jonjenkins31/Gradschool-Tactile-Sensor/DESIGN/66838005697__0D160AFB-0B24-4D78-8E8D-9A56586D88BA.jpeg

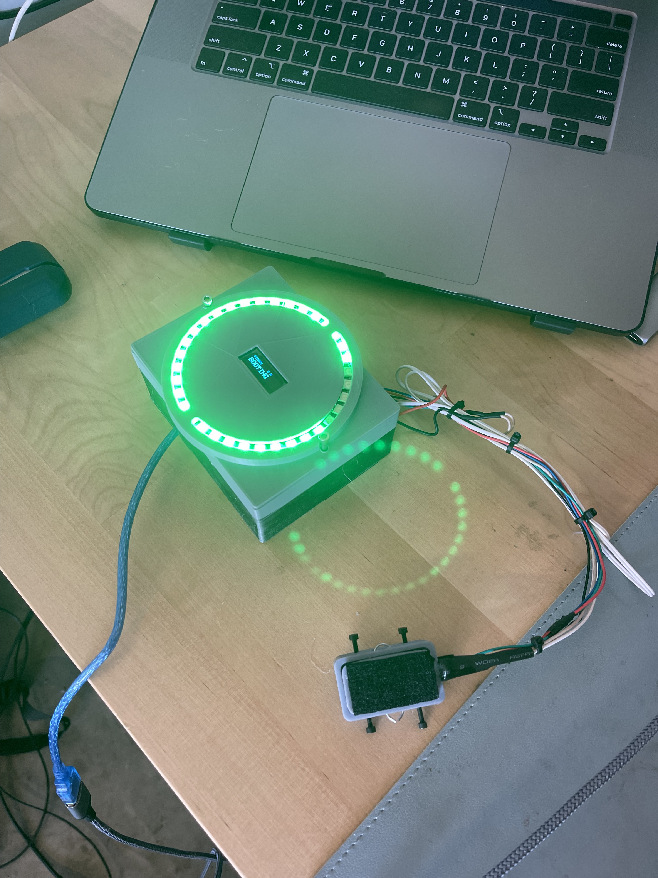
DESIGN/66838005697__0D160AFB-0B24-4D78-8E8D-9A56586D88BA.jpeg
