jonjenkins31/Gradschool-Tactile-Sensor/DIAGRAMS/SmartLedT4V5TeensyPinout.png

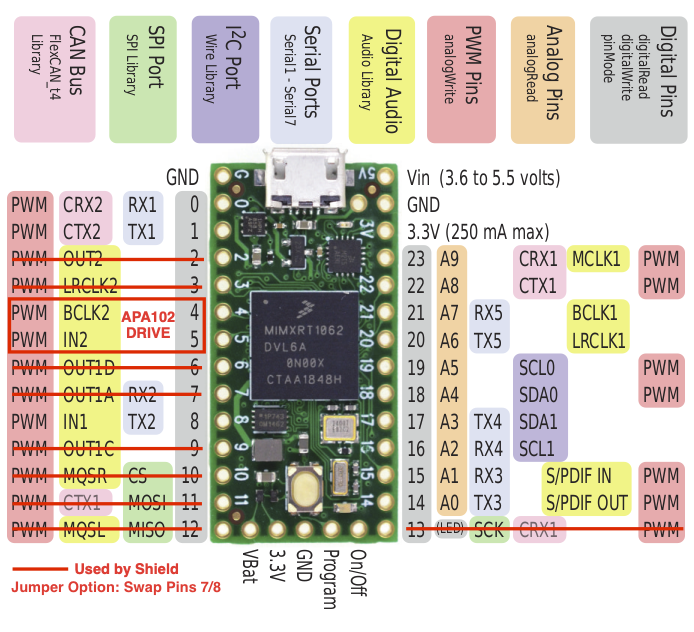
DIAGRAMS/SmartLedT4V5TeensyPinout.png
