jonjenkins31/Gradschool-Tactile-Sensor/README.md

## Grad School
# Grad School Tactile Sensor  

<!-- This is commented out.

 -->

## Project Information

Project Status : <mark style="background-color: green"> &nbsp; COMPLETED &nbsp;</mark>  
Code Status : <mark style="background-color: green"> &nbsp; GOOD &nbsp;</mark>  
Development Status : <mark style="background-color: red"> &nbsp; NOT ACTIVE &nbsp;</mark>  

&nbsp;
## General Information

 This is the project files for a biorobotic Tactile sensor. This is the first project for my biorobotics class. The goal of this project was to develope a robotic sensor capable of 3 types of sensor feedback. The project had the following key features: 
- [x] FDR sensor
- [x] Temperatre Sensor
- [x] Hall Effect sensor
- [x] LCD for text information and mode selection

&nbsp;
## WATCH NOW ON YOUTUBE

 Watch the project playlist on youtube. 

 &nbsp;

image alt text (https://www.youtube.com/watch?v=HfbRuyMDvio "YouTube")

-->

&nbsp;
## Support

Did this project help you? Consider supporting! 

Consider Subscribing: https://bit.ly/2DgZyuq <br>
Patreon ➔ https://www.patreon.com/JenkinsRobotics <br>
Venmo ➔ https://venmo.com/u/JenkinsRobotics <br>

&nbsp;
## Table of Contents

**[Project File Structure](#project-file-structure)**<br>
**[Installation Instructions](#installation-instructions)**<br>
**[Next Steps](#next-steps)**<br>
**[Components](#components)**<br>
**[Notes and Miscellaneous](#notes-and-miscellaneous)**<br>
**[Links](#links)**<br>

&nbsp;
## Project File Structure

The following is a breakdown of the different folders and the files contained in them:

1. **CAD**
    - A copy of my CAD assembly for this project in different formats.
    **Directions:**
      - Upload to your CAD file of chose to view files.

    &nbsp;
2. **CODE**  
   - This folder contains a copy all the arduino code I wrote for this project. Each file handels a specific task  and is called upon when needed. Documentation of the code is minimal. 

    &nbsp;
3. **DESIGN**
    - Contains copy of images of machine. 

    &nbsp;
4. **DIAGRAMS**
    - Contains copy of wire diagrams and any other prints.
   
    &nbsp;
5. **GH PAGES**
    - Files used for Github Pages and readme text file. 

    &nbsp;
6. **DOCUMENTS**
   - Contains user manuals for certain items  and submited documentation related for the project. 
    
      &nbsp;
7. **REFERENCES**
   - Contain random additional information used for the project. Including notes, images, reference code, etc. 

> Note: Files are not optimized and could contain unused code, references, documents. 

<!-- This is commented out.  

&nbsp;
## Installation Instructions

Installation instructions can be found in the youtube video linked below 
 
 ### Video link  be updated soon

[![image alt text](http://img.youtube.com/vi/w-qWbZ5-IQw/0.jpg)](https://youtube.com/playlist?list=PLNTKXZ4hgP_jekZOWw05JcJtyseCdSsIV "YouTube")

 -->

&nbsp;
## Next Steps

This project is now completed. No next steps are planned. We can release bug fixes if found. 

If you require assistant join our discord channel linked down below.

&nbsp;
## Components 

The following is a breakdown of key components for this project:
&nbsp;
| Item | Function | Cost  |
| --- |:---:| -----:|
| Fusion 360 | CAD | Free |
| arduio ide | Text Editor | Free |

&nbsp;
## Notes and Miscellaneous

Disclaimer :
Modify and use at your own risk. Code/project was not developed for mass production/use

**ENJOY!!**

That’s  all Folks. Hope this can help you in some way.
... Consider Supporting Us Down Below. 

&nbsp;
## Links

SUPPORT US ► 

Consider Subscribing: https://bit.ly/2DgZyuq <br>
Patreon ➔ https://www.patreon.com/JenkinsRobotics  <br>
Venmo ➔ https://venmo.com/u/JenkinsRobotics <br>

FOLLOW US ►

Discord ➔ https://discord.gg/sAnE5pRVyT <br>
Patreon ➔ https://www.patreon.com/JenkinsRobotics <br>
Twitter ➔ https://twitter.com/j <br>
Instagram  ➔ https://www.instagram.com/jenkinsrobotics/ <br>
Facebook ➔ https://www.facebook.com/jenkinsrobotics/  <br>
GitHub  ➔ https://jenkinsrobotics.github.io <br>
