jonjenkins31/Gradschool-Tactile-Sensor/DIAGRAMS/Screen Shot 2022-03-02 at 5.42.21 PM.png

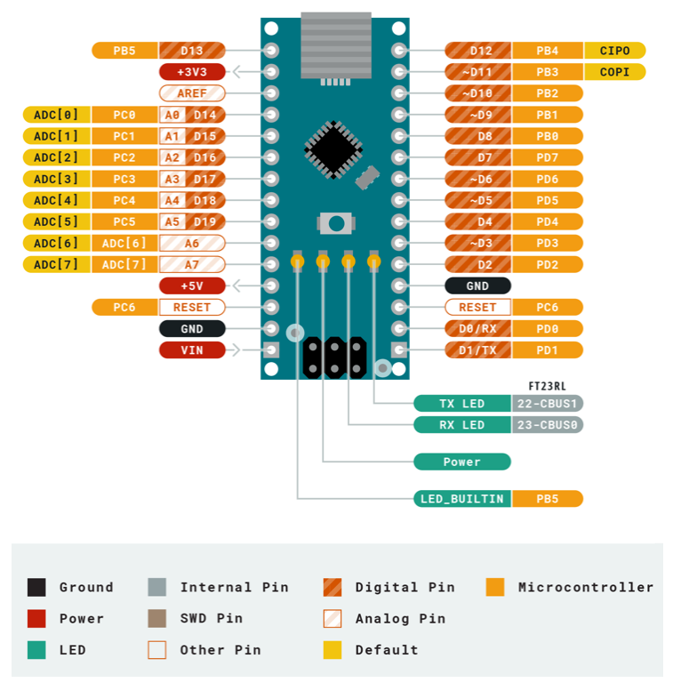
DIAGRAMS/Screen Shot 2022-03-02 at 5.42.21 PM.png
