jonjenkins31/Gradschool-Tactile-Sensor/DIAGRAMS/Screen Shot 2022-03-02 at 5.44.11 PM.png

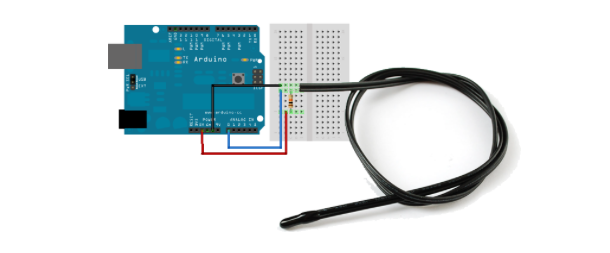
DIAGRAMS/Screen Shot 2022-03-02 at 5.44.11 PM.png
