jonjenkins31/Gradschool-Tactile-Sensor/DIAGRAMS/Screen Shot 2022-03-02 at 9.01.36 AM.png

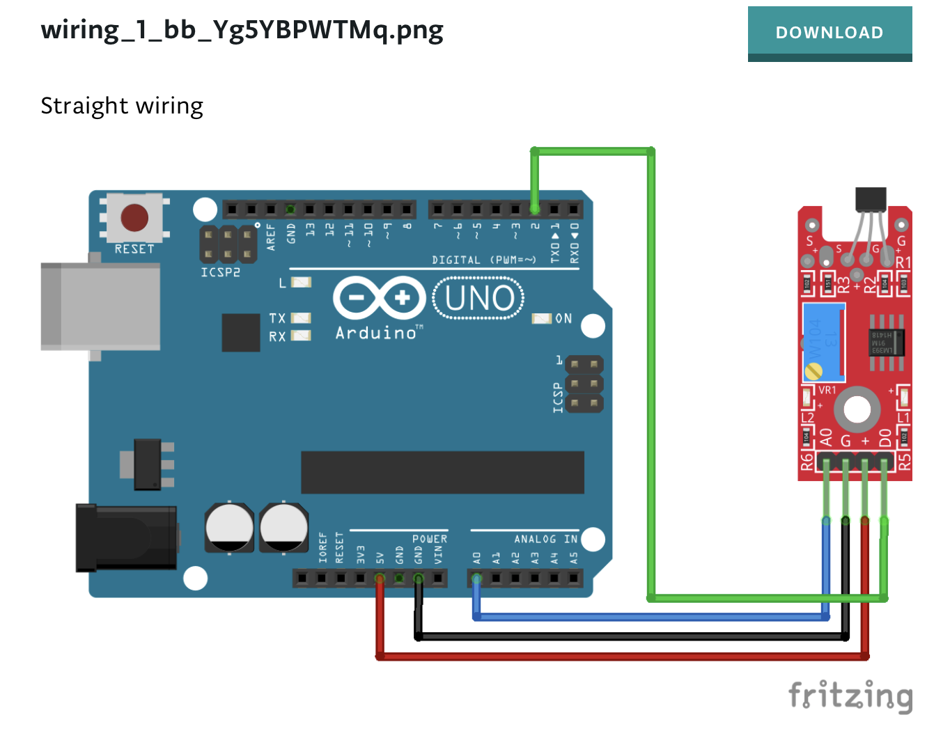
DIAGRAMS/Screen Shot 2022-03-02 at 9.01.36 AM.png
