jonjenkins31/Gradschool-Tactile-Sensor/DIAGRAMS/Screen Shot 2022-03-02 at 12.11.30 PM.png

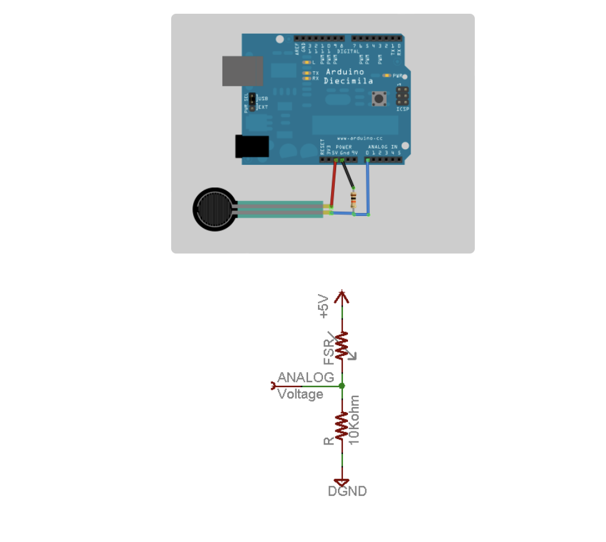
DIAGRAMS/Screen Shot 2022-03-02 at 12.11.30 PM.png
