jonjenkins31/Gradschool-Tactile-Sensor/DIAGRAMS/Screen Shot 2022-03-02 at 12.12.20 PM.png

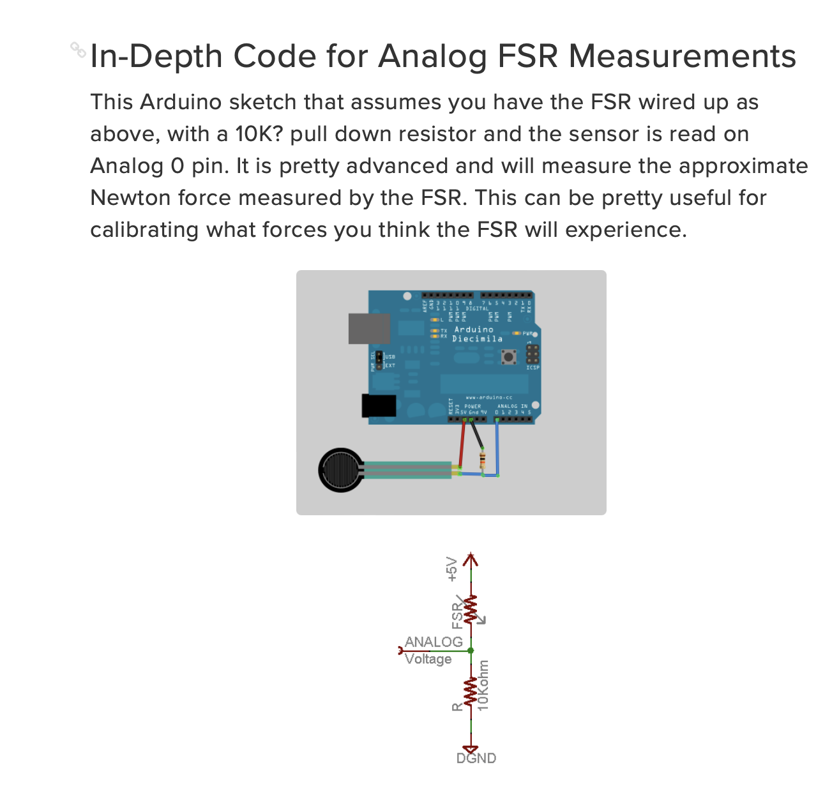
DIAGRAMS/Screen Shot 2022-03-02 at 12.12.20 PM.png
