jonjenkins31/Gradschool-Tactile-Sensor/DIAGRAMS/sensors_LIS3DH_sch.png

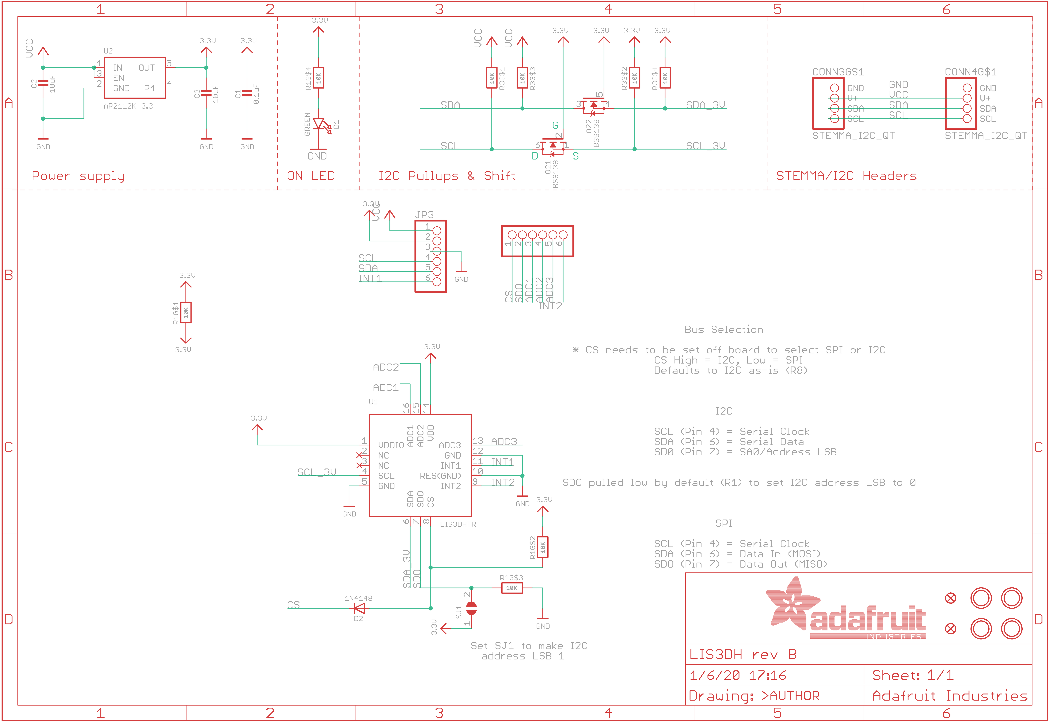
DIAGRAMS/sensors_LIS3DH_sch.png
