jonjenkins31/Gradschool-Tactile-Sensor/REFERENCES/CODE-master/PROJECT CODE/Gloves/MiMu xOSC Gloves/OSC-illoscope-master/OSC-illoscope With Triple-Axis Accelerometer.png

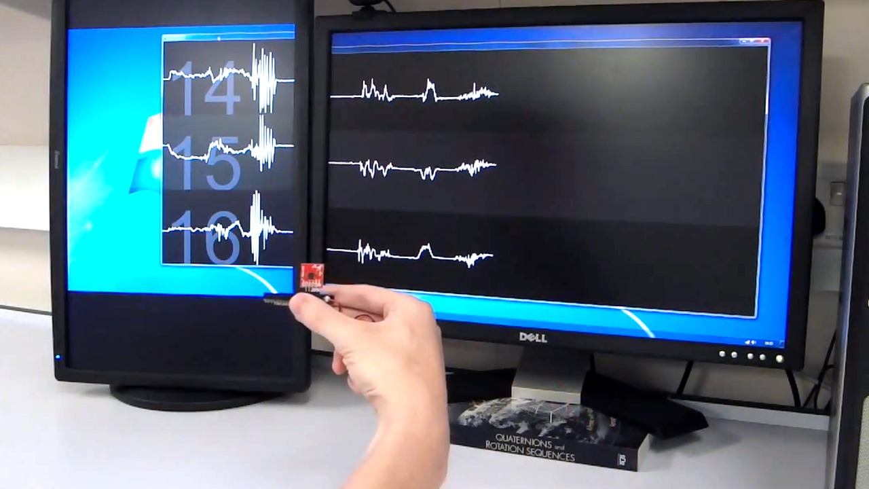
REFERENCES/CODE-master/PROJECT CODE/Gloves/MiMu xOSC Gloves/OSC-illoscope-master/OSC-illoscope With Triple-Axis Accelerometer.png
