jonjenkins31/Gradschool-Tactile-Sensor/REFERENCES/CODE-master/PROJECT CODE/rSkin/Processing/robot_skin_8chan_graph/screen-1137.tif

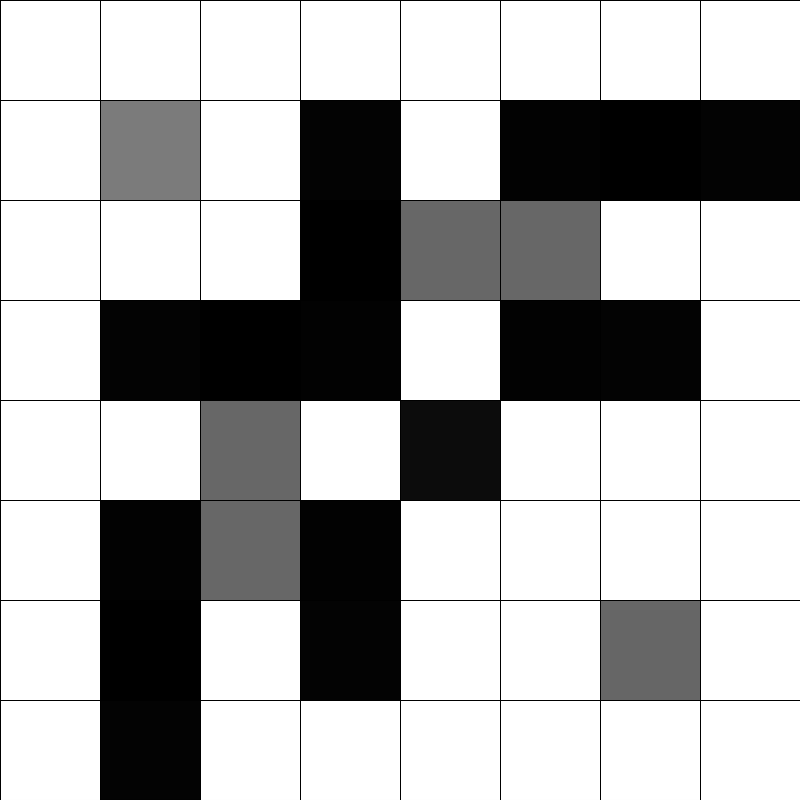
REFERENCES/CODE-master/PROJECT CODE/rSkin/Processing/robot_skin_8chan_graph/screen-1137.tif
