jonjenkins31/Gradschool-Tactile-Sensor/REFERENCES/CODE-master/PROJECT CODE/rSkin/Processing/robot_skin_square4/screen-6268.tif

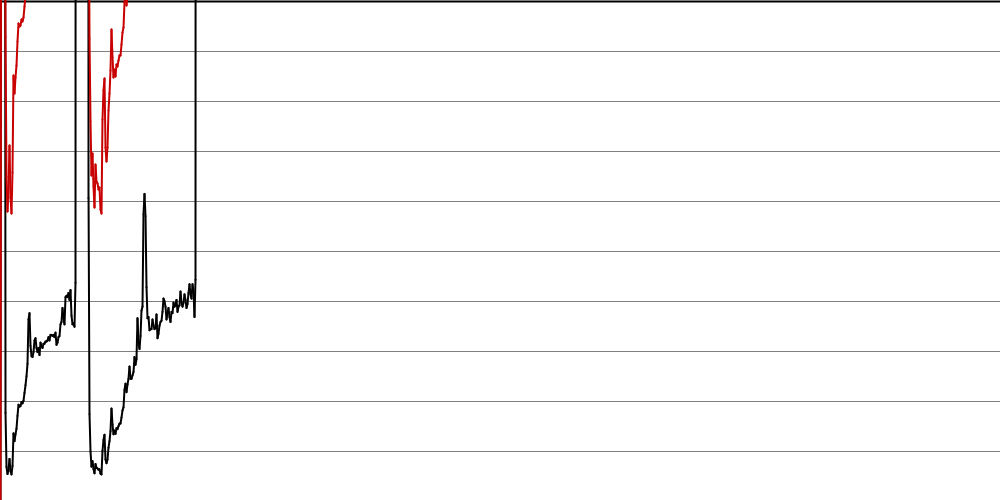
REFERENCES/CODE-master/PROJECT CODE/rSkin/Processing/robot_skin_square4/screen-6268.tif
