jonjenkins31/Gradschool-Tactile-Sensor/REFERENCES/CODE-master/PROJECT CODE/rSkin/Processing/robot_skin_square4/screen-7118.tif

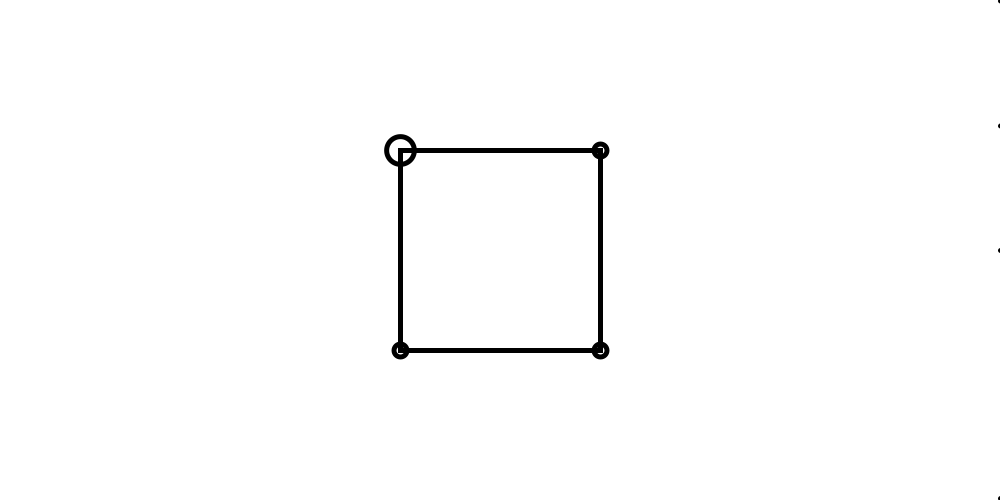
REFERENCES/CODE-master/PROJECT CODE/rSkin/Processing/robot_skin_square4/screen-7118.tif
