jonjenkins31/Gradschool-Tactile-Sensor/REFERENCES/CODE-master/WORKSHOP CODE/OTS-LilyPadArduino/sketches/01 Hello World/blink.jpg

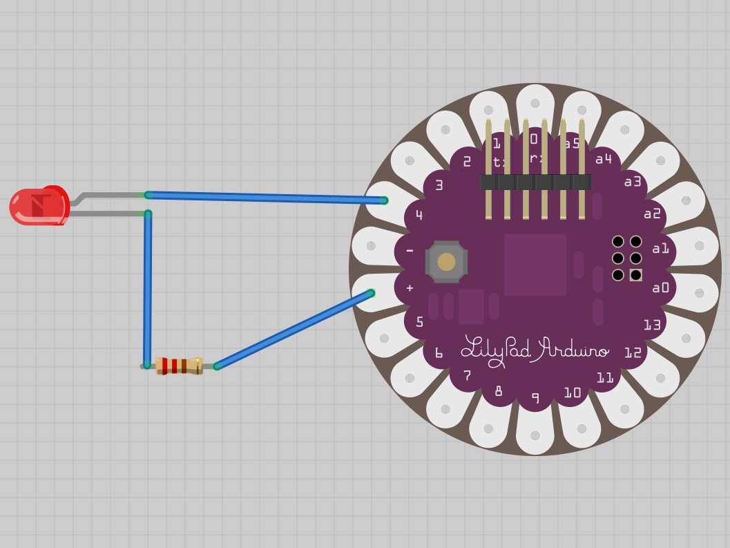
REFERENCES/CODE-master/WORKSHOP CODE/OTS-LilyPadArduino/sketches/01 Hello World/blink.jpg
