jonjenkins31/Gradschool-Tactile-Sensor/REFERENCES/CODE-master/WORKSHOP CODE/OTS-LilyPadArduino/sketches/02 Brightness/fade.jpg

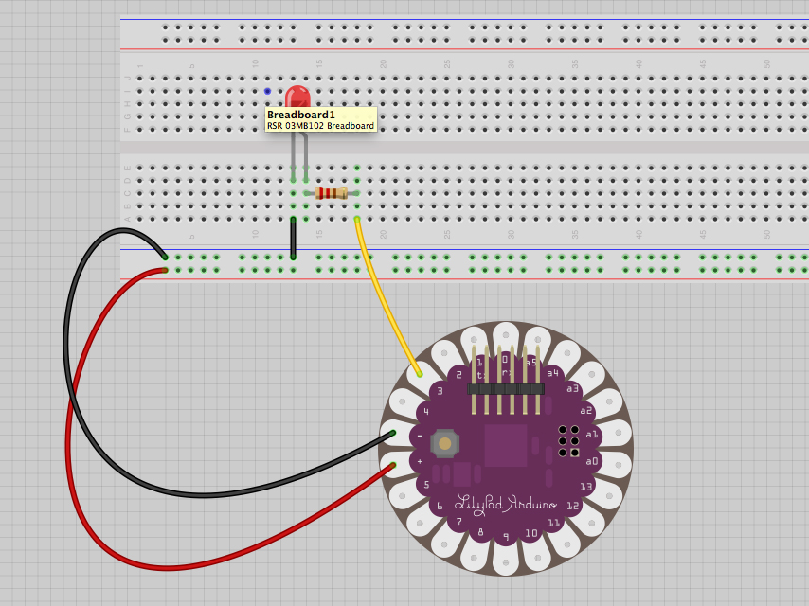
REFERENCES/CODE-master/WORKSHOP CODE/OTS-LilyPadArduino/sketches/02 Brightness/fade.jpg
