jonjenkins31/Gradschool-Tactile-Sensor/REFERENCES/CODE-master/WORKSHOP CODE/OTS-LilyPadArduino/sketches/03 Noise/noise.jpg

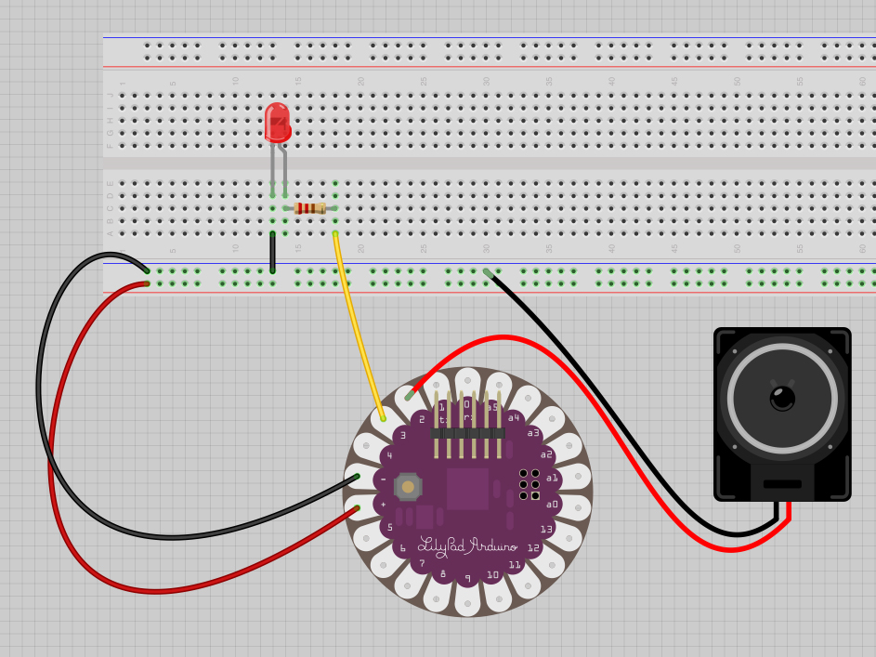
REFERENCES/CODE-master/WORKSHOP CODE/OTS-LilyPadArduino/sketches/03 Noise/noise.jpg
