jonjenkins31/Gradschool-Tactile-Sensor/REFERENCES/CODE-master/WORKSHOP CODE/OTS-LilyPadArduino/sketches/04-1 Analog In/analog-in.jpg

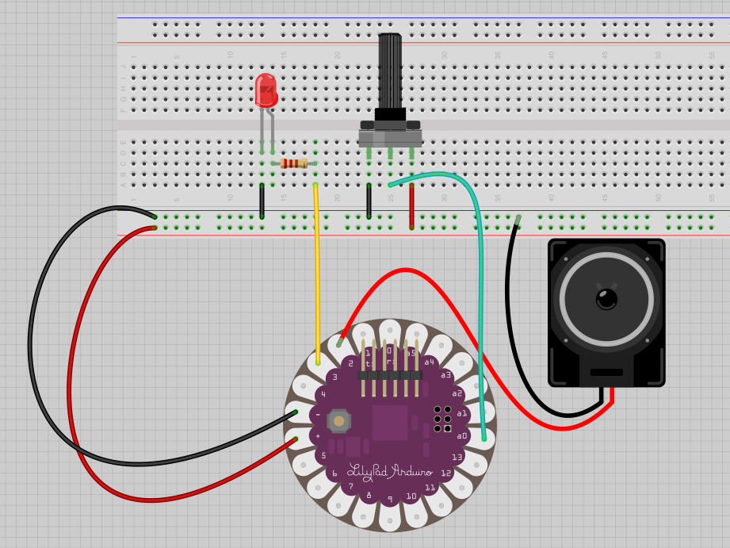
REFERENCES/CODE-master/WORKSHOP CODE/OTS-LilyPadArduino/sketches/04-1 Analog In/analog-in.jpg
