jonjenkins31/Gradschool-Tactile-Sensor/REFERENCES/CODE-master/WORKSHOP CODE/OTS-LilyPadArduino/sketches/04-2 Digital In/digital-in.jpg

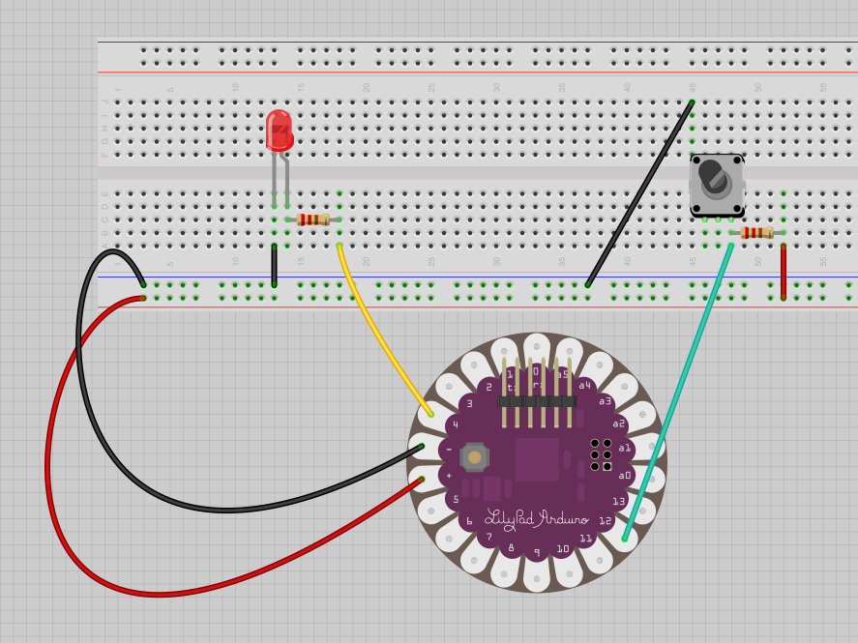
REFERENCES/CODE-master/WORKSHOP CODE/OTS-LilyPadArduino/sketches/04-2 Digital In/digital-in.jpg
