jonjenkins31/Gradschool-Tactile-Sensor/CAD/Enclosure v8.step

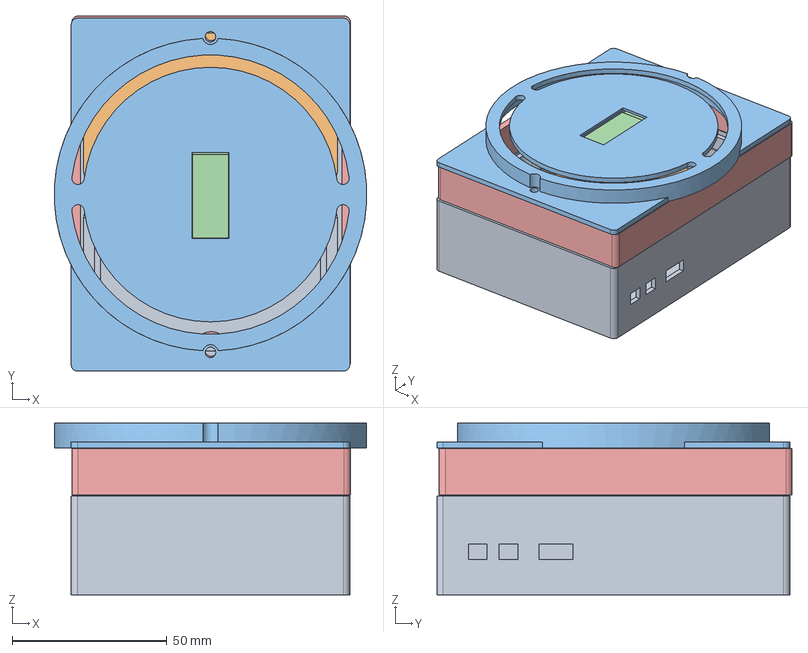
[picture p55: CAD file, 2024-01-01]
CAD/Enclosure v8.step
100.9 x 114.7 x 55.4 mm
lcd screen
