jonjenkins31/Gradschool-Tactile-Sensor/CAD/Tactile Sensor MK2 v15.step

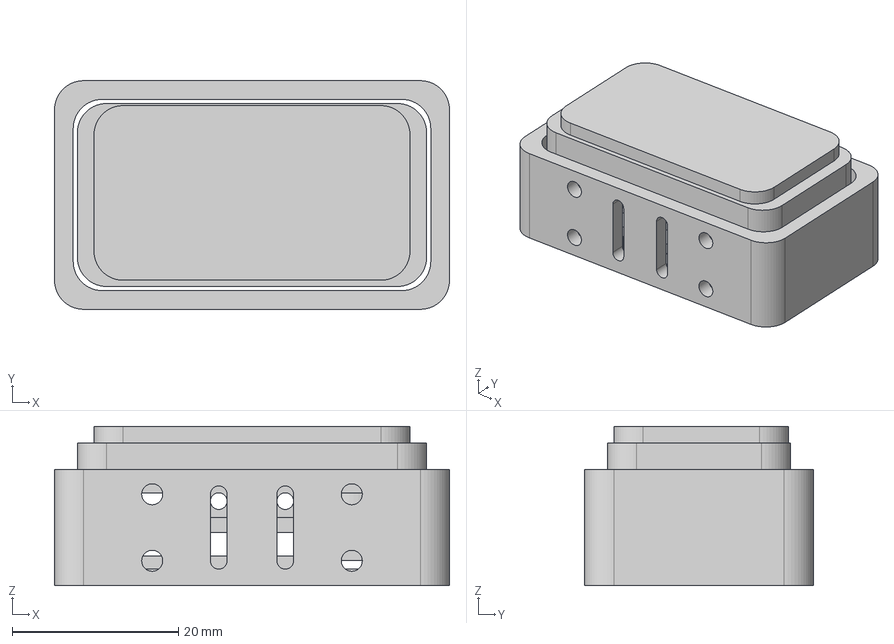
[picture p56: CAD file, 2024-01-01]
CAD/Tactile Sensor MK2 v15.step
47.5 x 27.5 x 19.2 mm
49E Hall Sensor LM393
Resistance Paer
nylon wire vertical
termistor (2)
silicon membrane
