jonjenkins31/Gradschool-Tactile-Sensor/(list of files, cad)

Other CAD files:
DIAGRAMS/TouchSensorWD.dwg
CAD/Enclosure v8.f3d
CAD/Tactile Sensor MK2 v15.f3d
