jonjenkins31/Gradschool-Tactile-Sensor/DIAGRAMS/sensors_LIS3DH_fab_print.png

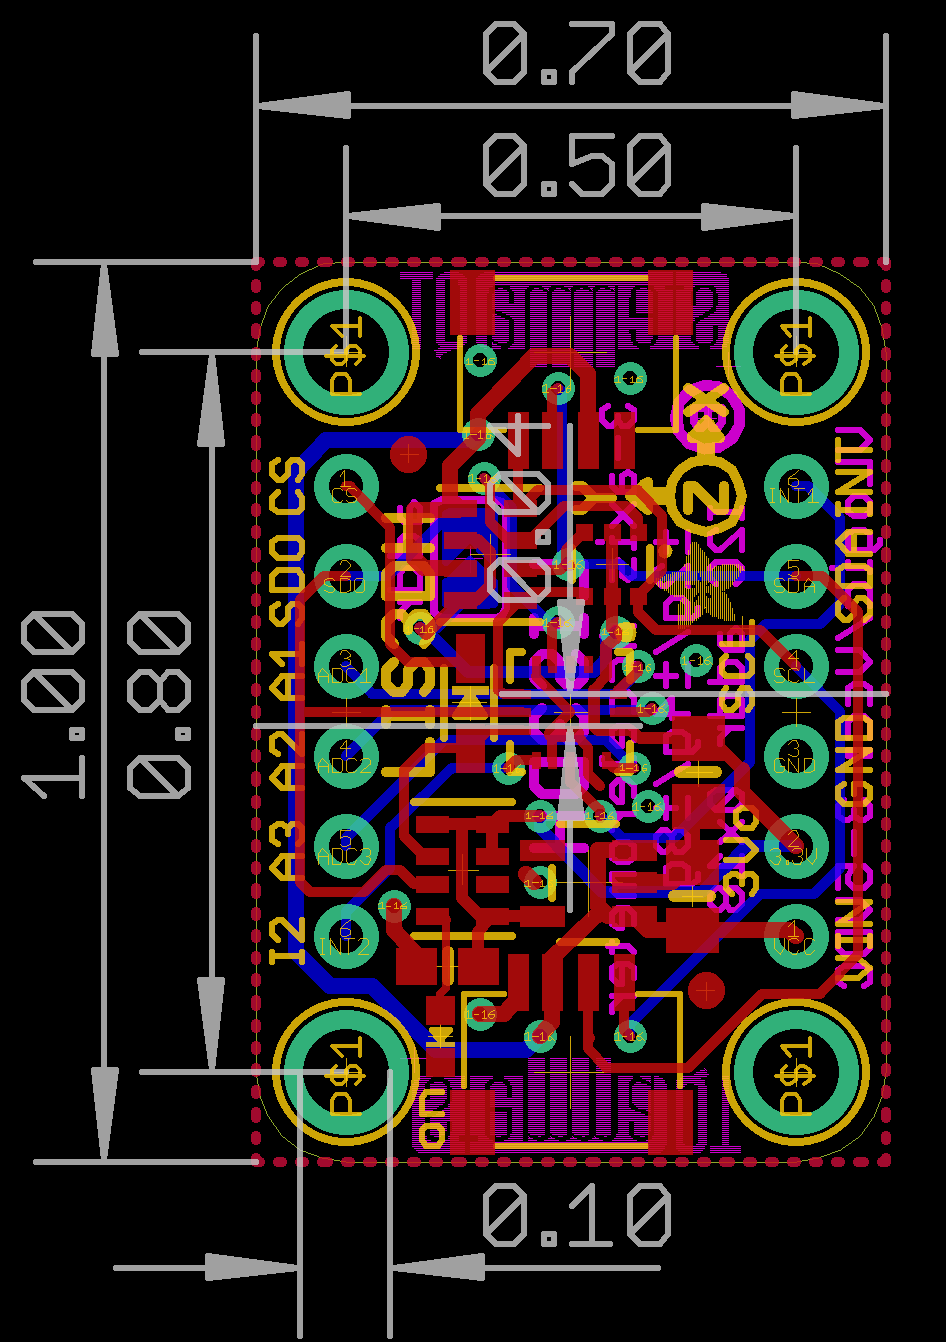
DIAGRAMS/sensors_LIS3DH_fab_print.png
