jonjenkins31/Gradschool-Tactile-Sensor/DIAGRAMS/TouchSensorWD v2.pdf

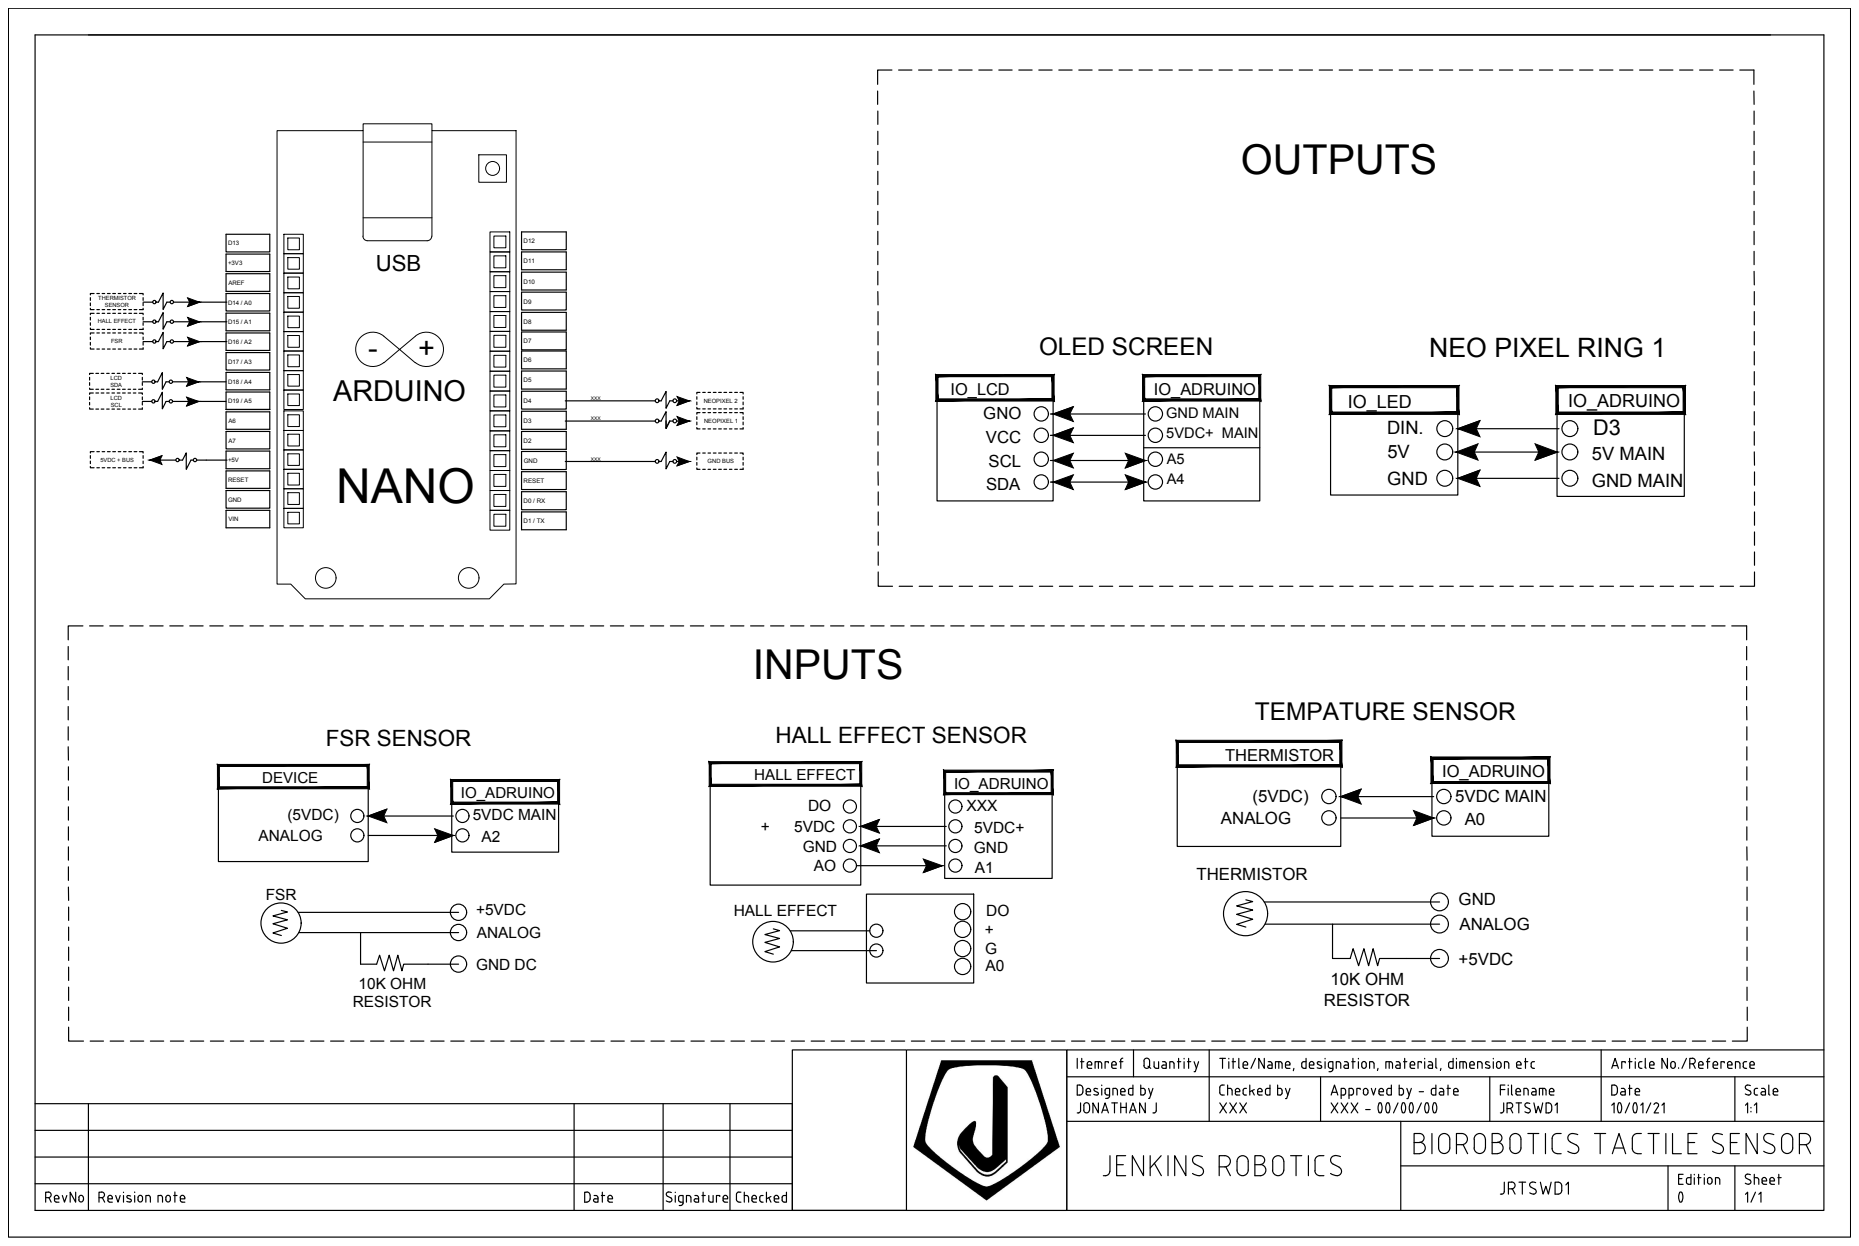
[picture p58: page 1]
