jonjenkins31/Gradschool-Tactile-Sensor/DIAGRAMS/TouchSensorWD.pdf

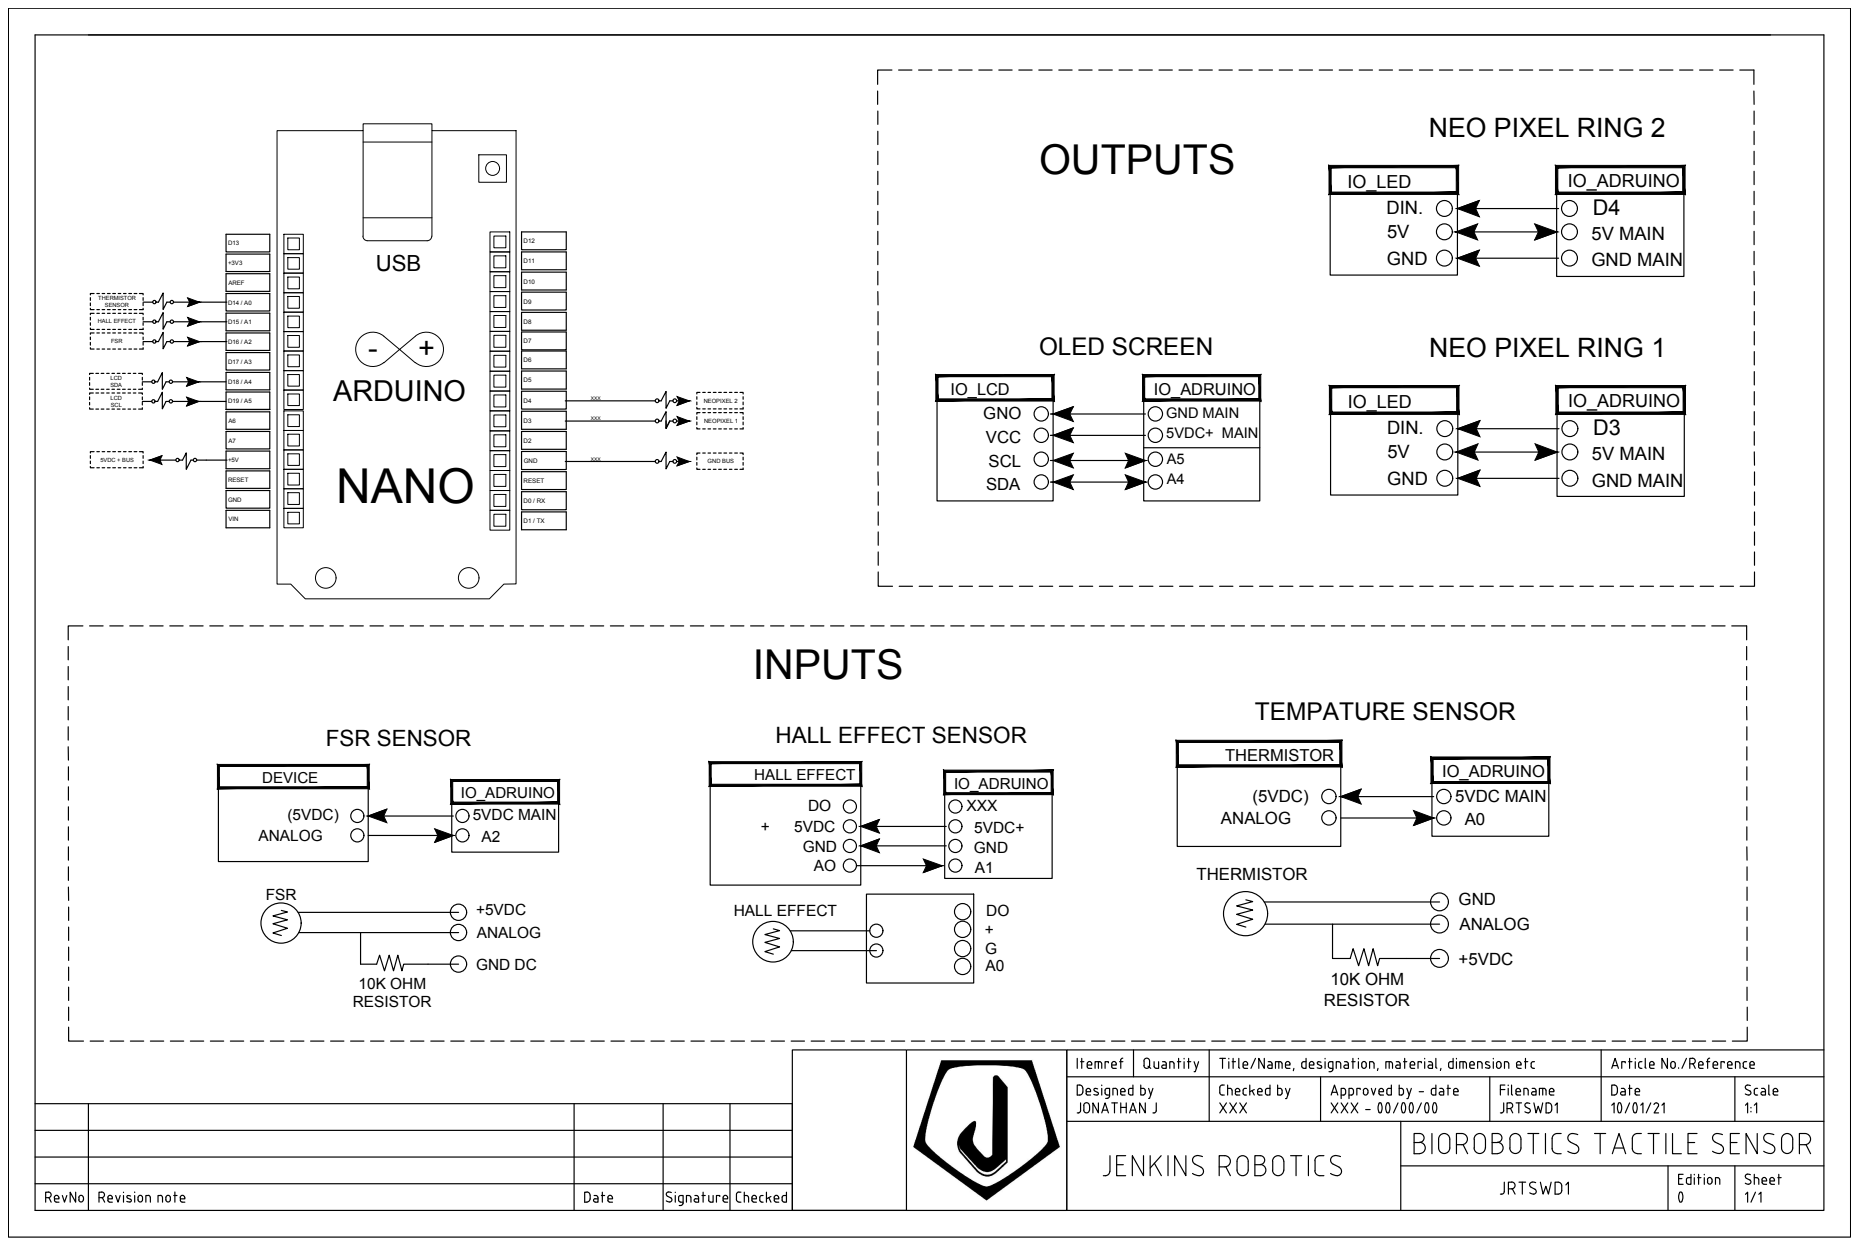
[picture p59: page 1]
