jonjenkins31/Gradschool-Tactile-Sensor/(list of files, drawings)

Other design files:
REFERENCES/CODE-master/WORKSHOP CODE/ArduinoOTS/sketches/01 Hello World/Blink.fzz
REFERENCES/CODE-master/WORKSHOP CODE/ArduinoOTS/sketches/02 Brightness/Fading.fzz
REFERENCES/CODE-master/WORKSHOP CODE/ArduinoOTS/sketches/03 Noise/Noise.fzz
REFERENCES/CODE-master/WORKSHOP CODE/ArduinoOTS/sketches/04 Analog In/Sound_Light.fzz
REFERENCES/CODE-master/WORKSHOP CODE/ArduinoOTS/sketches/05 Sequencer/Sequencer-4pots.fzz
REFERENCES/CODE-master/WORKSHOP CODE/OTS-LilyPadArduino/sketches/01 Hello World/Blink.fzz
REFERENCES/CODE-master/WORKSHOP CODE/OTS-LilyPadArduino/sketches/02 Brightness/Fading.fzz
REFERENCES/CODE-master/WORKSHOP CODE/OTS-LilyPadArduino/sketches/03 Noise/Noise.fzz
REFERENCES/CODE-master/WORKSHOP CODE/OTS-LilyPadArduino/sketches/04-1 Analog In/Sound_Light.fzz
REFERENCES/CODE-master/WORKSHOP CODE/OTS-LilyPadArduino/sketches/04-2 Digital In/PushbuttonRead.fzz
REFERENCES/CODE-master/WORKSHOP CODE/OTS-LilyPadArduino/sketches/05 Sequencer/Sequencer-4pots.fzz
