jonjenkins31/Gradschool-Tactile-Sensor/REFERENCES/muca-hardware-master/MucaS/MucaS.sch

## KiCad design REFERENCES/muca-hardware-master/MucaS/MucaS.sch (2024-01-01)

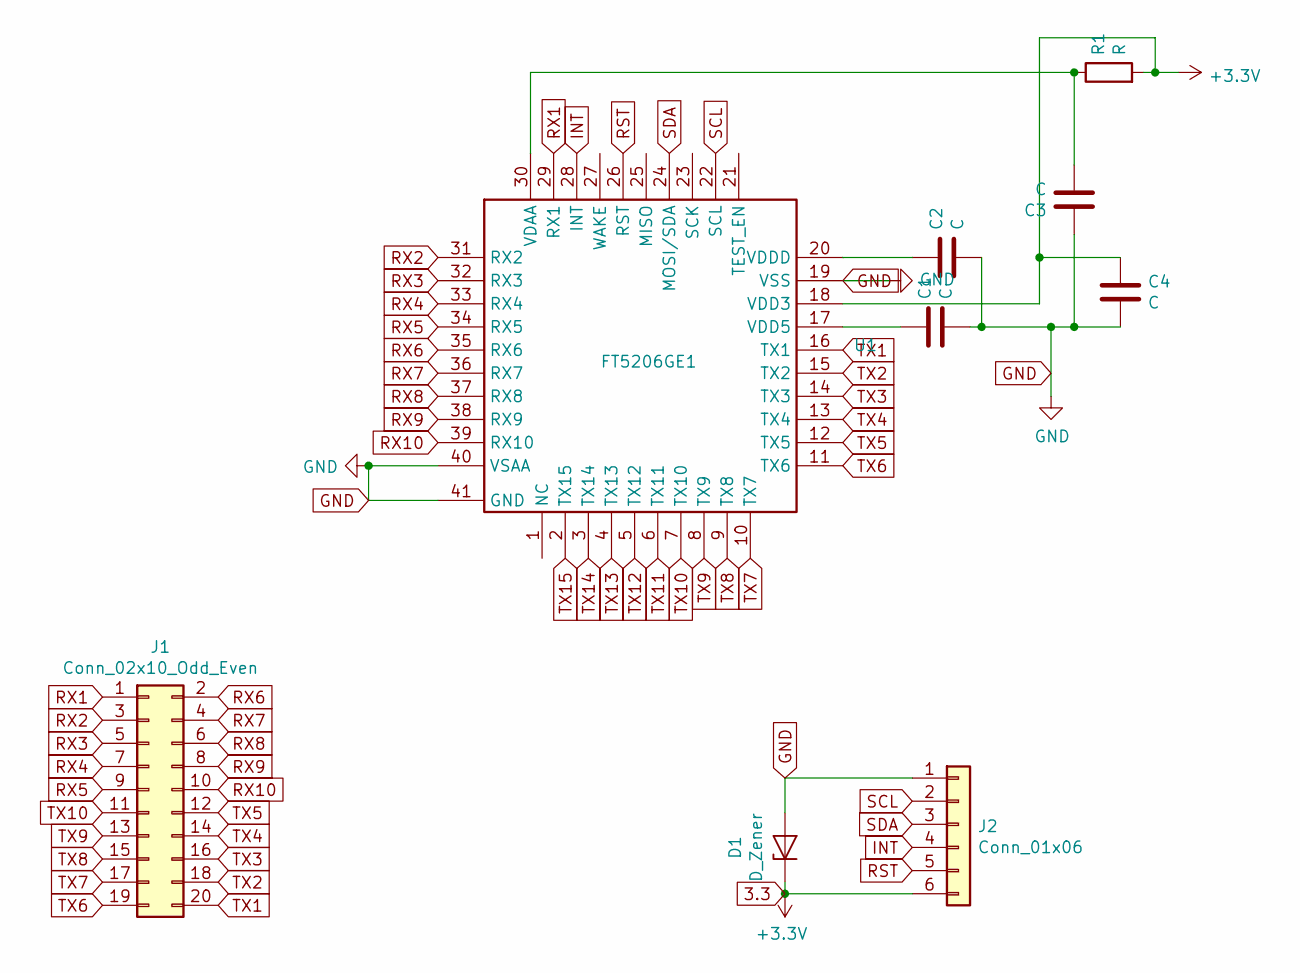
[picture p60: schematic MucaS.sch]

Parts:
C1, C2, C3, C4: C; C_0603_1608Metric
D1: D_Zener; D_SOD-523
J1: Conn_02x10_Odd_Even; PinHeader_2x10_P2.54mm_Vertical
J2: Conn_01x06; PinHeader_1x06_P2.54mm_Vertical
R1: R; R_0603_1608Metric
U1: FT5206GE1; QFN40P500X500X80-41N

Connections:
+3.3V: C4.1, D1.1 (K), J2.6, R1.2, U1.18 (VDD3)
GND: C1.2, C2.2, C3.1, C4.2, D1.2 (A), J2.1, U1.19 (VSS), U1.40 (VSAA), U1.41 (GND)
INT: J2.4, U1.28 (INT)
unnamed: C1.1, U1.17 (VDD5)
unnamed: C2.1, U1.20 (VDDD)
unnamed: C3.2, R1.1, U1.30 (VDAA)
RST: J2.5, U1.26 (RST)
RX1: J1.1, U1.29 (RX1)
RX2: J1.3, U1.31 (RX2)
RX3: J1.5, U1.32 (RX3)
RX4: J1.7, U1.33 (RX4)
RX5: J1.9, U1.34 (RX5)
RX6: J1.2, U1.35 (RX6)
RX7: J1.4, U1.36 (RX7)
RX8: J1.6, U1.37 (RX8)
RX9: J1.8, U1.38 (RX9)
RX10: J1.10, U1.39 (RX10)
SCL: J2.2, U1.22 (SCL)
SDA: J2.3, U1.24 (MOSI/SDA)
TX1: J1.20, U1.16 (TX1)
TX2: J1.18, U1.15 (TX2)
TX3: J1.16, U1.14 (TX3)
TX4: J1.14, U1.13 (TX4)
TX5: J1.12, U1.12 (TX5)
TX6: J1.19, U1.11 (TX6)
TX7: J1.17, U1.10 (TX7)
TX8: J1.15, U1.9 (TX8)
TX9: J1.13, U1.8 (TX9)
TX10: J1.11, U1.7 (TX10)
TX11: U1.6 (TX11)
TX12: U1.5 (TX12)
TX13: U1.4 (TX13)
TX14: U1.3 (TX14)
TX15: U1.2 (TX15)
