jonjenkins31/Gradschool-Tactile-Sensor/REFERENCES/muca-hardware-master/MucaXL/MucaXL.sch

## KiCad design REFERENCES/muca-hardware-master/MucaXL/MucaXL.sch (2024-01-01)

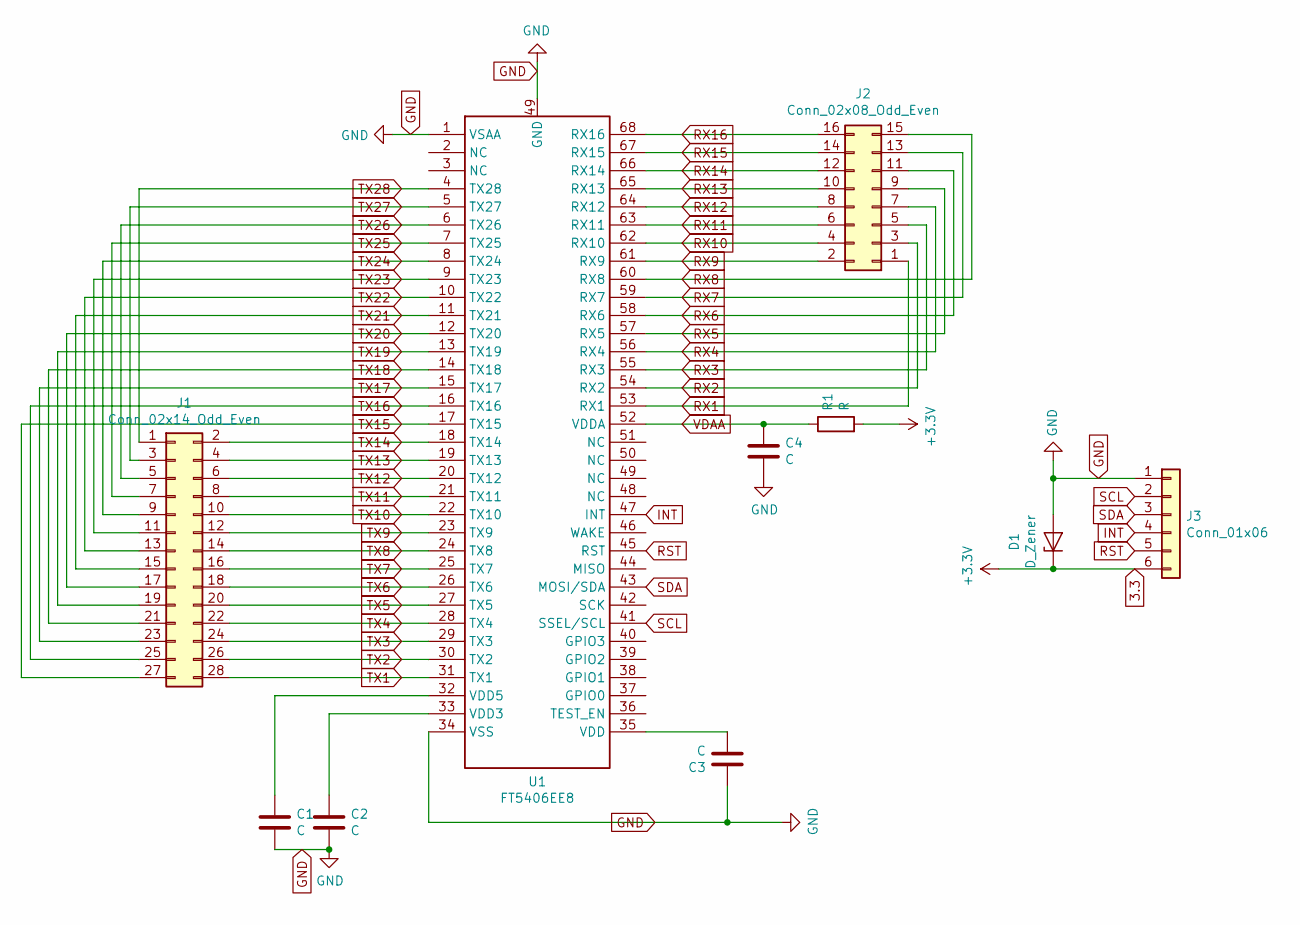
[picture p61: schematic MucaXL.sch]

Parts:
C1, C2, C3, C4: C; C_0603_1608Metric
D1: D_Zener; D_SOD-523
J1: Conn_02x14_Odd_Even; PinSocket_2x14_P2.54mm_Vertical
J2: Conn_02x08_Odd_Even; PinSocket_2x08_P2.54mm_Vertical
J3: Conn_01x06; PinHeader_1x06_P2.54mm_Vertical
R1: R; R_0603_1608Metric
U1: FT5406EE8; QFN40P800X800X90-69N

Connections:
+3.3V: D1.1 (K), J3.6, R1.2
GND: C1.2, C2.2, C3.1, C4.2, D1.2 (A), J3.1, U1.1 (VSAA), U1.34 (VSS), U1.49 (GND)
INT: J3.4, U1.47 (INT)
unnamed: C1.1, U1.32 (VDD5)
unnamed: C2.1, U1.33 (VDD3)
unnamed: C3.2, U1.35 (VDD)
RST: J3.5, U1.45 (RST)
RX1: J2.1, U1.53 (RX1)
RX2: J2.3, U1.54 (RX2)
RX3: J2.5, U1.55 (RX3)
RX4: J2.7, U1.56 (RX4)
RX5: J2.9, U1.57 (RX5)
RX6: J2.11, U1.58 (RX6)
RX7: J2.13, U1.59 (RX7)
RX8: J2.15, U1.60 (RX8)
RX9: J2.2, U1.61 (RX9)
RX10: J2.4, U1.62 (RX10)
RX11: J2.6, U1.63 (RX11)
RX12: J2.8, U1.64 (RX12)
RX13: J2.10, U1.65 (RX13)
RX14: J2.12, U1.66 (RX14)
RX15: J2.14, U1.67 (RX15)
RX16: J2.16, U1.68 (RX16)
SCL: J3.2, U1.41 (SSEL/SCL)
SDA: J3.3, U1.43 (MOSI/SDA)
TX1: J1.28, U1.31 (TX1)
TX2: J1.26, U1.30 (TX2)
TX3: J1.24, U1.29 (TX3)
TX4: J1.22, U1.28 (TX4)
TX5: J1.20, U1.27 (TX5)
TX6: J1.18, U1.26 (TX6)
TX7: J1.16, U1.25 (TX7)
TX8: J1.14, U1.24 (TX8)
TX9: J1.12, U1.23 (TX9)
TX10: J1.10, U1.22 (TX10)
TX11: J1.8, U1.21 (TX11)
TX12: J1.6, U1.20 (TX12)
TX13: J1.4, U1.19 (TX13)
TX14: J1.2, U1.18 (TX14)
TX15: J1.27, U1.17 (TX15)
TX16: J1.25, U1.16 (TX16)
TX17: J1.23, U1.15 (TX17)
TX18: J1.21, U1.14 (TX18)
TX19: J1.19, U1.13 (TX19)
TX20: J1.17, U1.12 (TX20)
TX21: J1.15, U1.11 (TX21)
TX22: J1.13, U1.10 (TX22)
TX23: J1.11, U1.9 (TX23)
TX24: J1.9, U1.8 (TX24)
TX25: J1.7, U1.7 (TX25)
TX26: J1.5, U1.6 (TX26)
TX27: J1.3, U1.5 (TX27)
TX28: J1.1, U1.4 (TX28)
VDAA: C4.1, R1.1, U1.52 (VDDA)
